aaromalonline/cardiokey/README.md

[↗️ Zeroth presentation](https://www.canva.com/design/DAG_zeX-wzA/ZkK1dH2pC3Fdq6ULEdo5fw/edit)  
[overleaf](https://www.overleaf.com/project/699ae507008f60bd259c76a1)  
[notebooklm](https://notebooklm.google.com/notebook/c7a1f9f1-c57d-4788-8593-7c4eff9a2088)
