aaromalonline/cardiokey/ppt_report/CardioKey(ECGID)-Zerothppt.pdf

### Analog ECG Signal Acquisition & Biometrics

# CardioKey (ECGID)

### Mini-project

# Team Members :

## 1. Aardra S V - 24101868 2.Aaromal A - 24101880 3.Abdulla Hilal V K - 24101000 4.Abhijith R S - 24102771

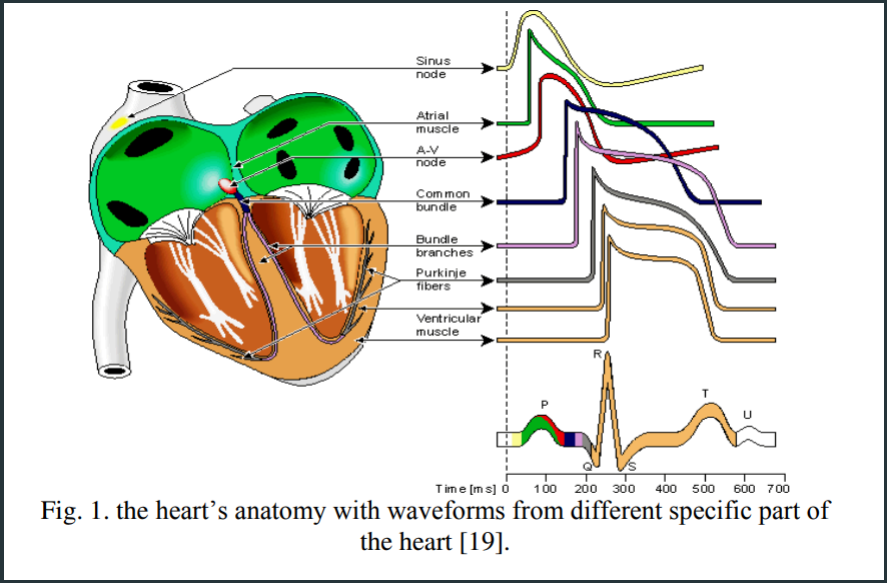
[picture p26: figure]

Traditional biometric methods (fingerprint, face ID) are vulnerable to spoofing and external modification. Passwords and tokens can be stolen or lost.

We propose to build a analog implimentation of Electrocardiogram (ECG) as a biometric identifier. The core of ECGID lies in the unique anatomical and physiological characteristics of an individual's heart, which dictate the specific morphology of the P, QRS, and T waves.

# Abstract

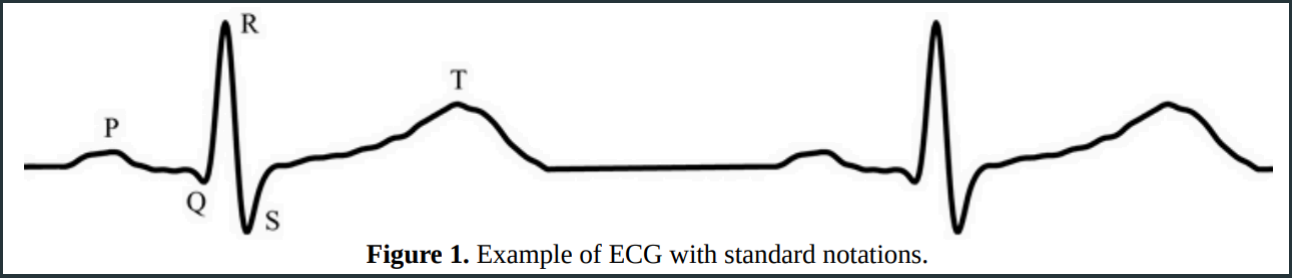
[picture p27: figure]

## P Wave

Represents the first
upward deflection and
atrial depolarization

## QRS Complex

Composed of Q, R, and S
waves; represents
ventricular
depolarization. This is the most distinctive fragment
for identification.

## T Wave

Represents ventricular
repolarization,
concurrent with the end
of ventricular systole.

## U Wave

A series of waves
following the T wave,
discernible in some
tracings.

# 1. ECG & Characteristics

Muscle contraction causes depolarization, which is detected as voltage changes on the skin's surface over time.

two cardiac cycles

1
Universality : Every living human generates ECG signals continuously.

2

4

3

# key points of biometric identification

### Uniqueness: Waveforms are influenced by heart location, size, geometric shape, chest

structure, age, and physiological characteristics.

### Stability: Adult heartbeat structures are basically fixed; waveforms remain stable over

time unless lesions or major pathologies (like myocardial infarction) occur.

### Measurability: Modern equipment is miniaturized and portable, allowing for high-precision acquisition. eg : using 12 lead electrodes for accuracy

ECG variability due Heart rate varibility → shortening of diastole duration (the baseline fragment of the ECG) and the ventricular depolarization period (corresponding to the ST segment in the ECG) and attenuation of the R wave amplitude but QRS complex remains constant

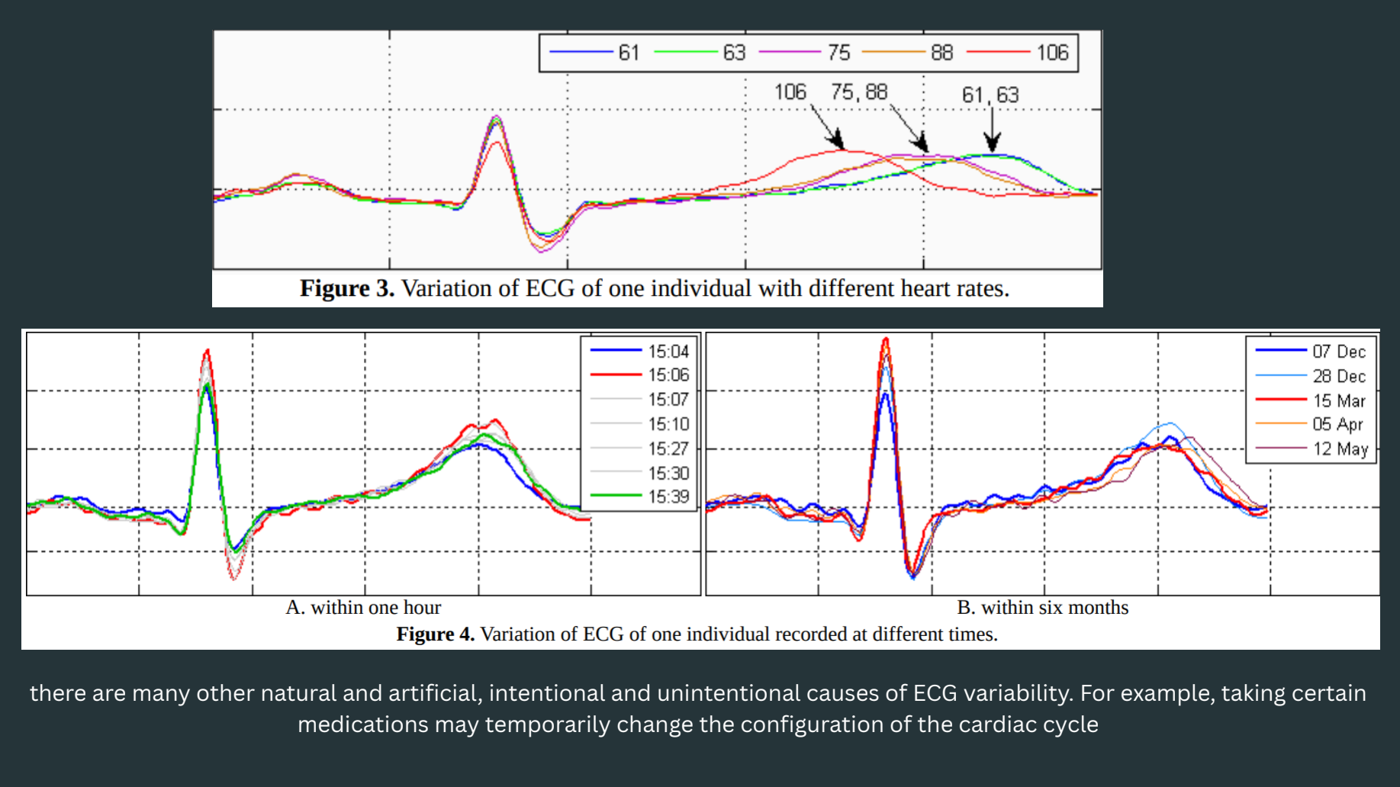
[picture p28: page 6]

there are many other natural and artificial, intentional and unintentional causes of ECG variability. For example, taking certain medications may temporarily change the configuration of the cardiac cycle

The system utilizes a precision analog front-end based on the AD620 instrumentation amplifier to acquire low-amplitude heart signals. This signal is digitized and processed using digital signal processing (DSP) techniques to extract the P-QRS-T complex.

# Methodology

### Hardware components : ECG Analog Signal Acquisition

3 electrodes (1Lead LA-RA, feedback), AD620 instrumentation amp, AD705J, IC741 opamps for filters and

### amplifiers, and resistors & capacitors → AD8232 ECG sensor Diodes for DC offset circuit, AD115 16bit ADC, a MCU (ESP32)

### Software components : ECG Digital Signal Analysis & Biometrics

### MATLAB or Python, TinyML and algorithms for signal analysis

# 2. Analog ECG Signal Acquisition - Hardware

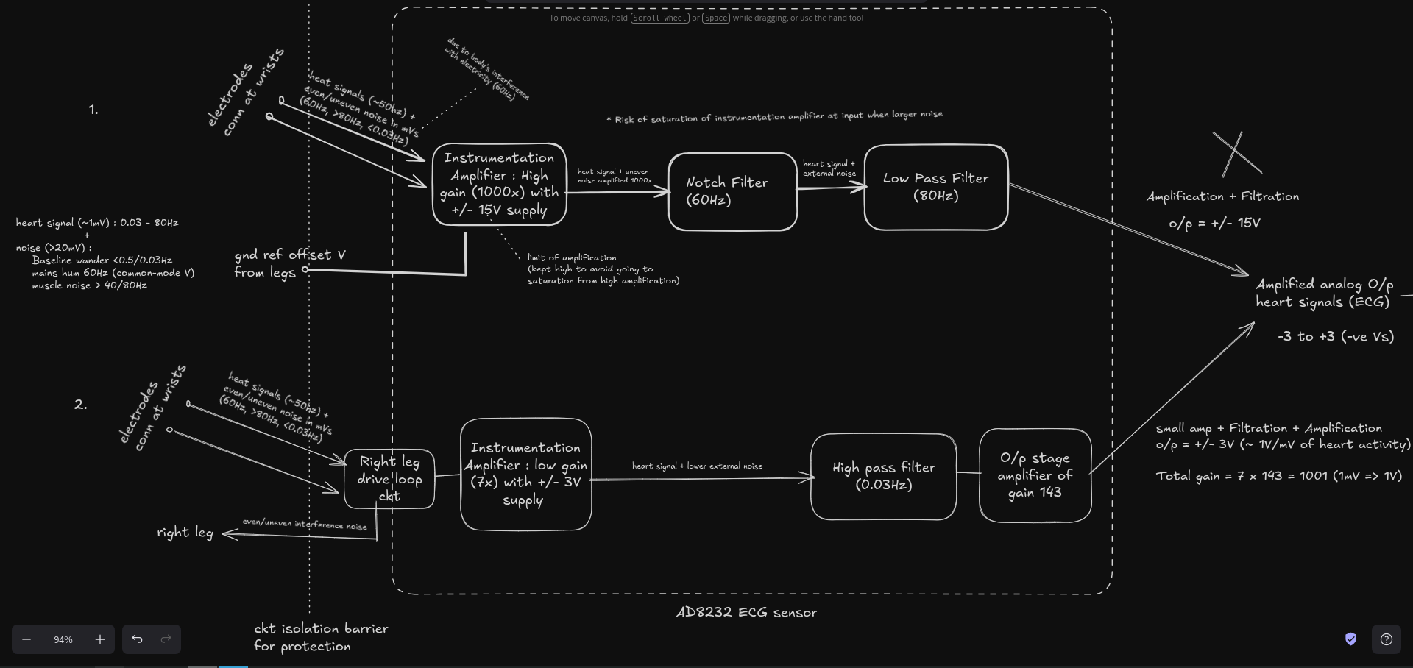
[picture p29: page 8]

two approaches

## Right leg drive circuit

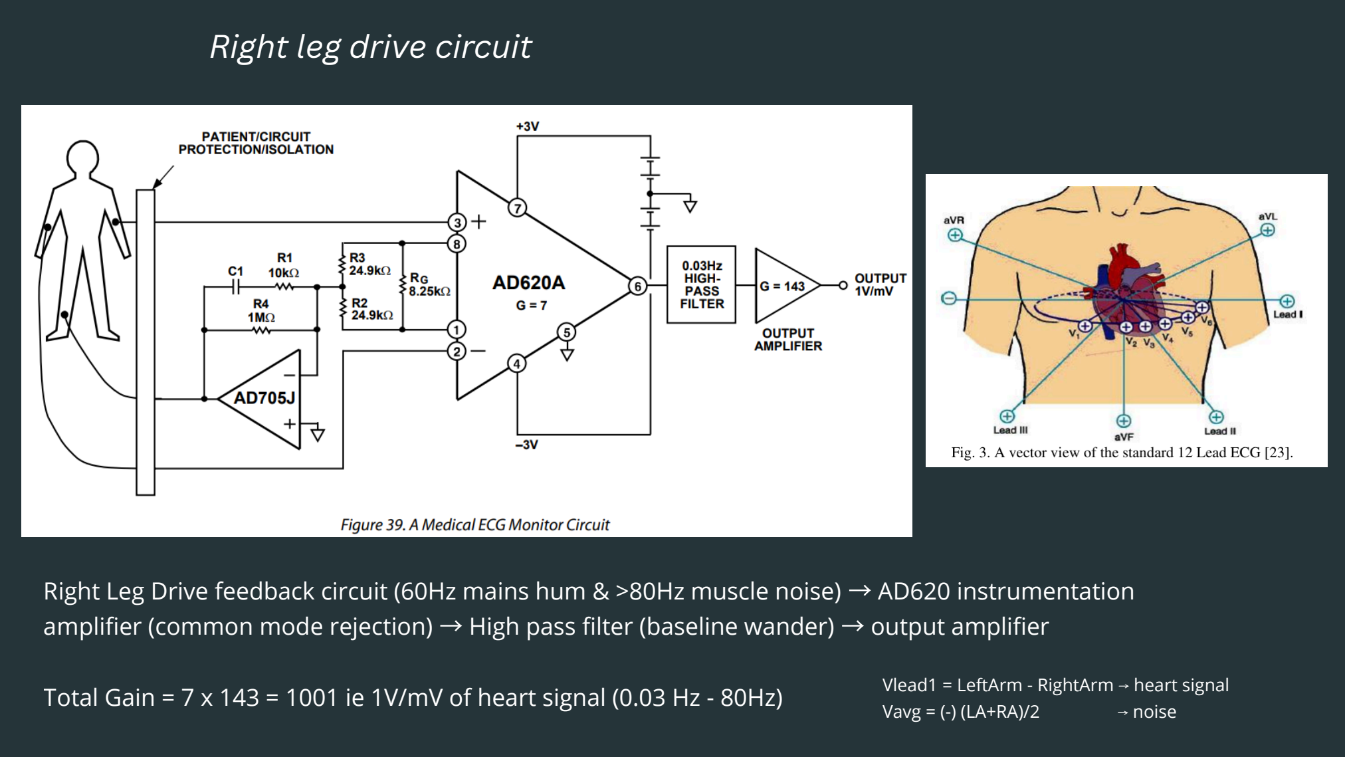
[picture p30: page 9]

Right Leg Drive feedback circuit (60Hz mains hum & >80Hz muscle noise) → AD620 instrumentation amplifier (common mode rejection) → High pass filter (baseline wander) → output amplifier

Total Gain = 7 x 143 = 1001 ie 1V/mV of heart signal (0.03 Hz - 80Hz)

Vlead1 = LeftArm - RightArm ⟶ heart signal
Vavg = (-) (LA+RA)/2 | ⟶ noise

## Simulation & Tests :

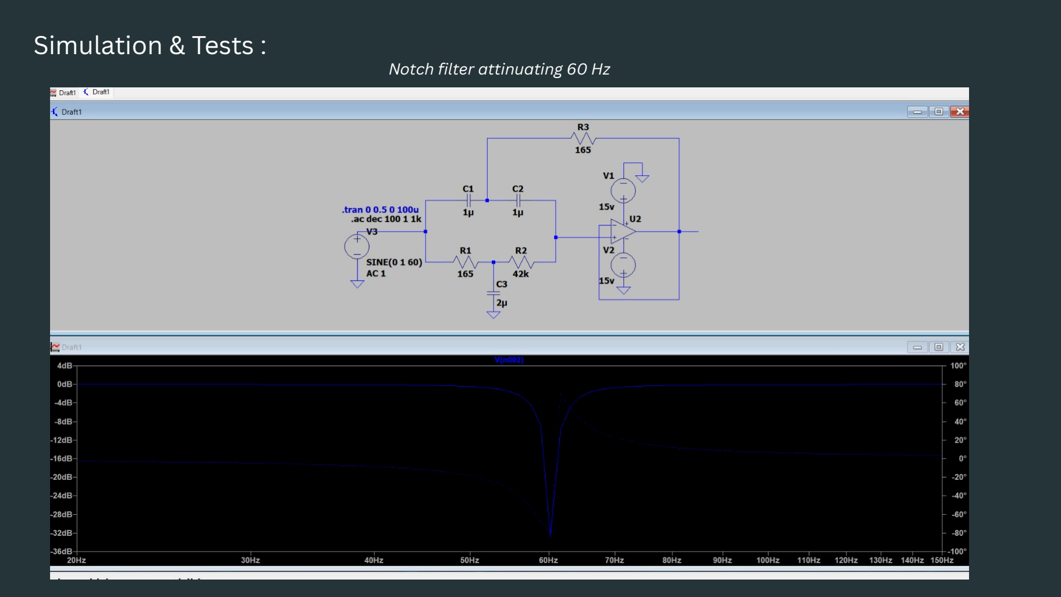
[picture p31: page 10]

Notch filter attinuating 60 Hz

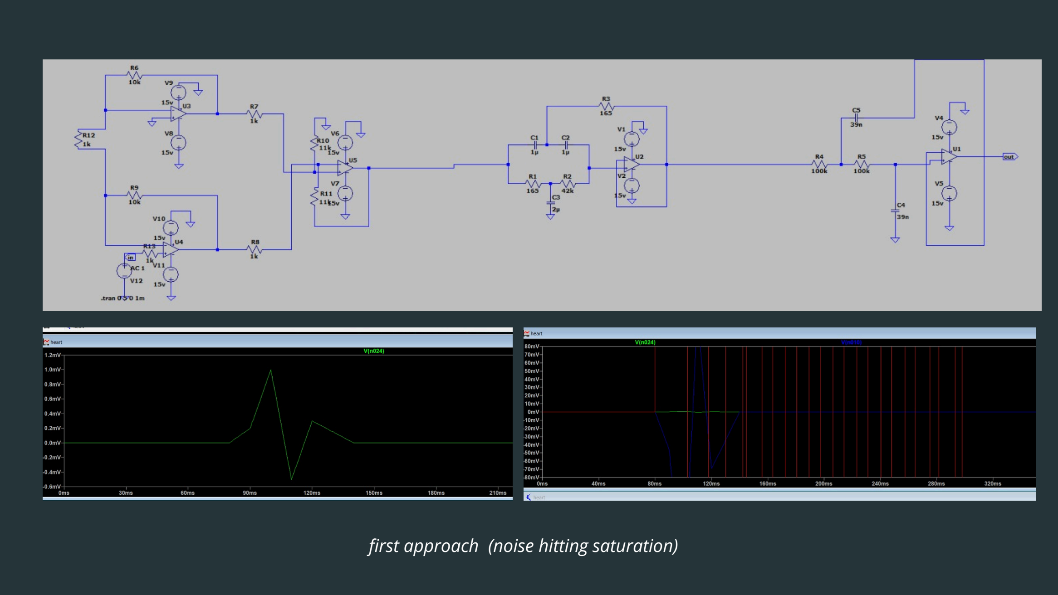
[picture p32: page 11]

first approach (noise hitting saturation)

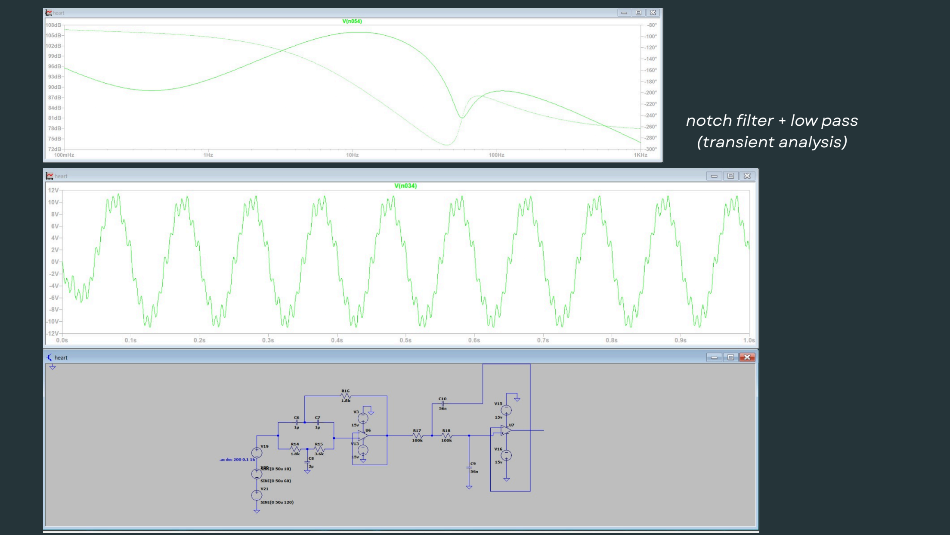
[picture p33: page 12]

notch filter + low pass
(transient analysis)

# 3. ECG Digital Signal Analysis - Software

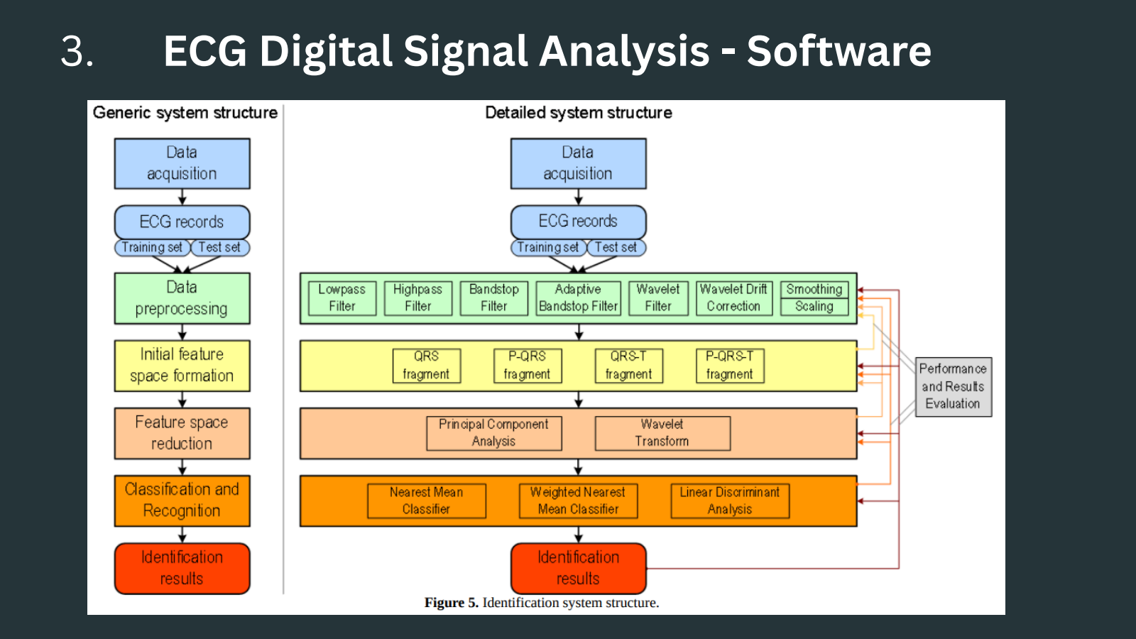
[picture p34: page 13]

1 Data Acquisition : Single-lead ECG (Lead I: Left Arm – Right Arm), sample 500Hz, 16bit signal

2

4

3

Data Preprocessing (Cleaning) : Drift Correction for baseline wander (wavelet decomposition or high pass), Mains hum removal (Adaptive Bandstop/notch filter), HIgh frequency cleanup (low pass butterworth 50-80Hz)

Initial Feature Space Formation : "Segmentation" phase where the continuous signal is chopped into individual heartbeats (cardiac cycle), Fragment Selection (P-QRS-T fragment out of QRS, P-QRS, QRS-T, and P-QRS-T windows provided the highest accuracy because the P-wave contains significant individual data), Window Size (window length of 0.5 seconds (250 samples) for every beat) aligned with R peak reference (80 samples before the peak and 170 samples after it), extracted 10 beats per record to choose a mean beat.

Feature Space Reduction (PCA) : Raw P-QRS-T window of 250 data points compressed into 30 pricipal components (vectors) using normalisation and dimensionality reduction for nullifying heart rate variations.
5

Classification & Identification : This final stage compares the user's 30-point "signature" against the database using Nearest Mean, Weighted Nearest Mean, or Linear Discriminant Analysis (LDA) algorithms with majority matches for multiple beats (cardiac cycle).

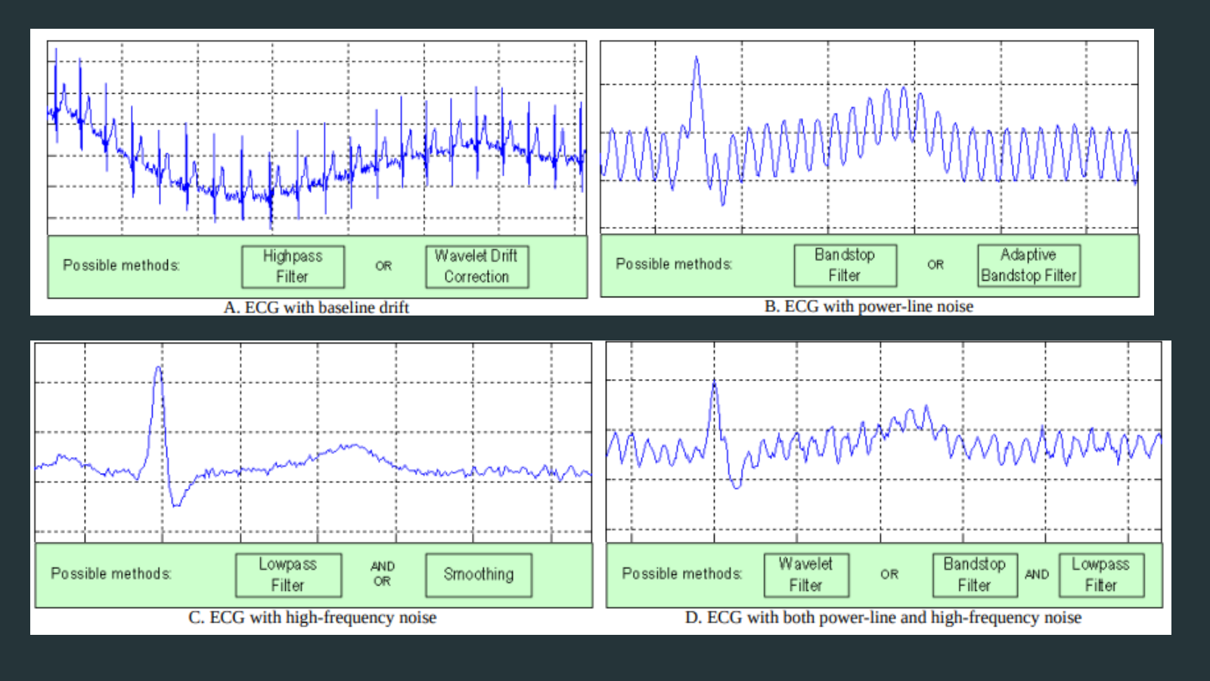
[picture p35: page 15]
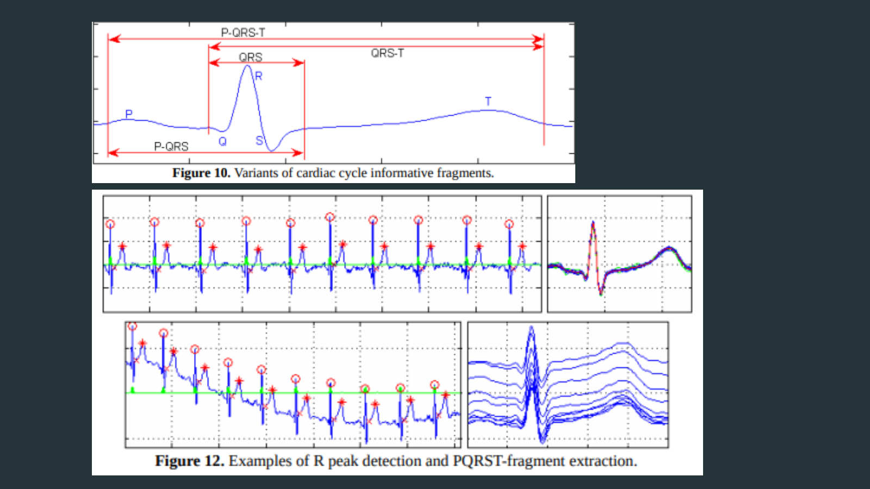
[picture p36: page 16]

## Observations :

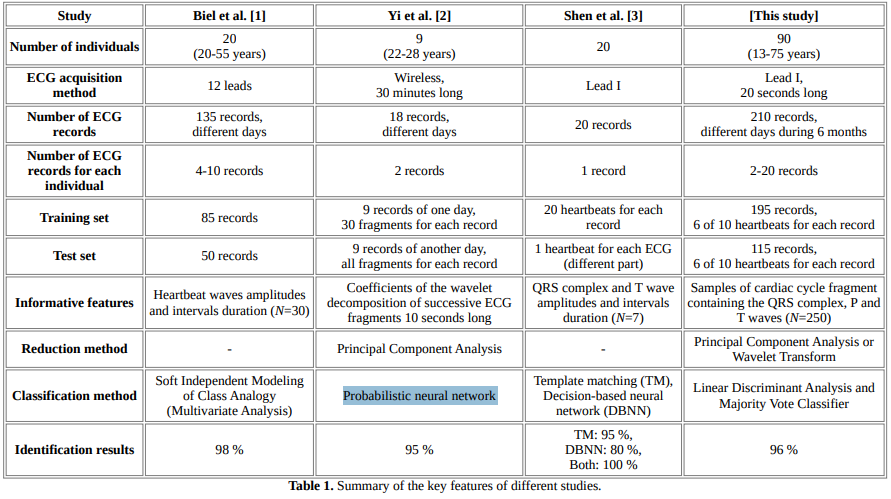
[picture p37: page 17]

# Conclusion

Project Viability
The "CardioKey" system demonstrates that the Electrocardiogram (ECG) is a viable, universal, and unique biometric trait for human identification.
Research confirms that using a Single-Lead (Lead I) configuration can achieve identification accuracy rates as high as 96% under controlled conditions.

Advantages Over Traditional Biometrics
ECG biometrics provides inherent "Liveness Detection,

" making it superior to fingerprint or face ID, which can be spoofed by static images or models.
It offers a continuous method of authentication that is difficult to forge or steal.

Future Scope & Challenges
The primary challenge remains Heart Rate Variability (HRV). As identified in recent studies, identification accuracy drops significantly (the "Rest-Ex" problem) if the user has just exercised.
Future improvements will focus on advanced Normalization Algorithms (scaling the QT interval) to ensure the system remains robust even when the user's heart rate is elevated, also introducing more leads for accuracy.

# References

https://scispace.com/pdf/heart-rate-monitoring-and-pqrst-detection-based-on-graphical-2s4gcfab00.pdf

https://www.physionet.org/physiobank/database/ecgiddb/biometric.shtml

https://www.sciencedirect.com/science/article/pii/S2667099221000086

https://repository.lib.pcr.ac.id/id/eprint/1602/1/Paper%20PQRST%20wave%20detection%20on%20ECG%20signals%20(1).pdf

https://repository.lib.pcr.ac.id/id/eprint/1602/1/Paper%20PQRST%20wave%20detection%20on%20ECG%20signals%20(1).pdf (https://www.instructables.com/Make-Your-Own-Electrocardiogram-ECG/)

https://www.analog.com/media/en/technical-documentation/data-sheets/AD620.pdf
