aaromalonline/cardiokey/ck-client_app/outs/pred/subj1-pred.jpeg

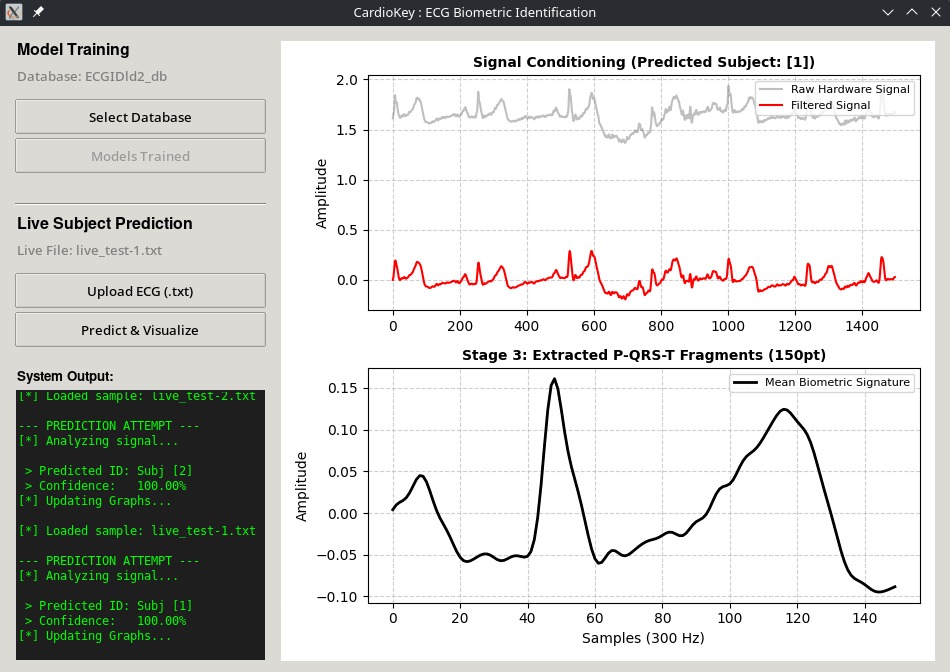
ck-client_app/outs/pred/subj1-pred.jpeg
