aaromalonline/cardiokey/ck-client_app/outs/pred/subj1-prednew.jpeg

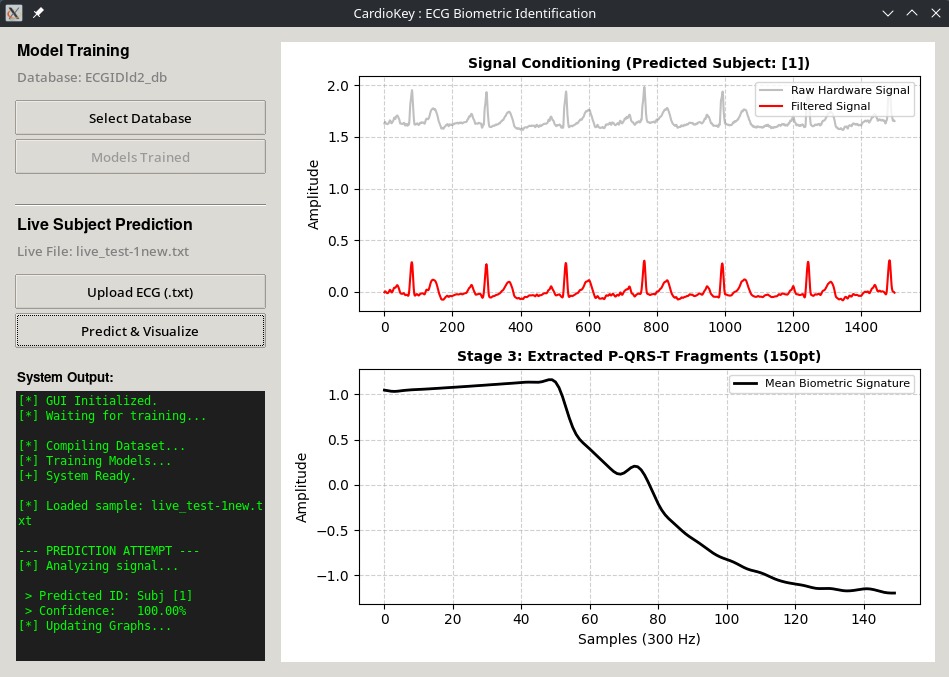
ck-client_app/outs/pred/subj1-prednew.jpeg
