aaromalonline/cardiokey/ck-client_app/outs/pred/subj2-pred.jpeg

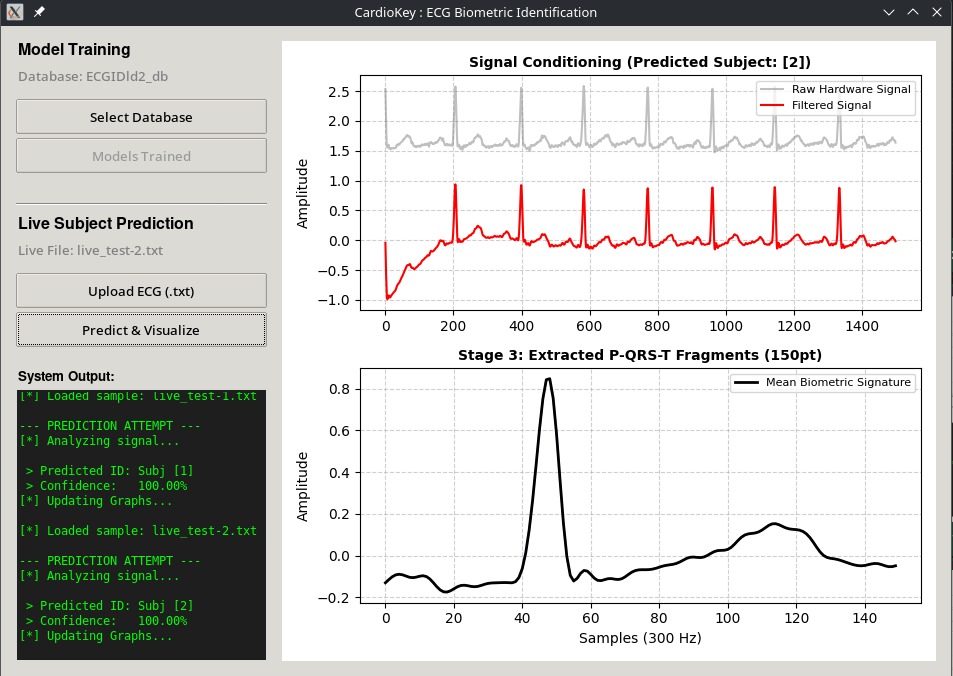
ck-client_app/outs/pred/subj2-pred.jpeg
