aaromalonline/cardiokey/ck-client_app/outs/rec/subj1-dbrec.jpeg

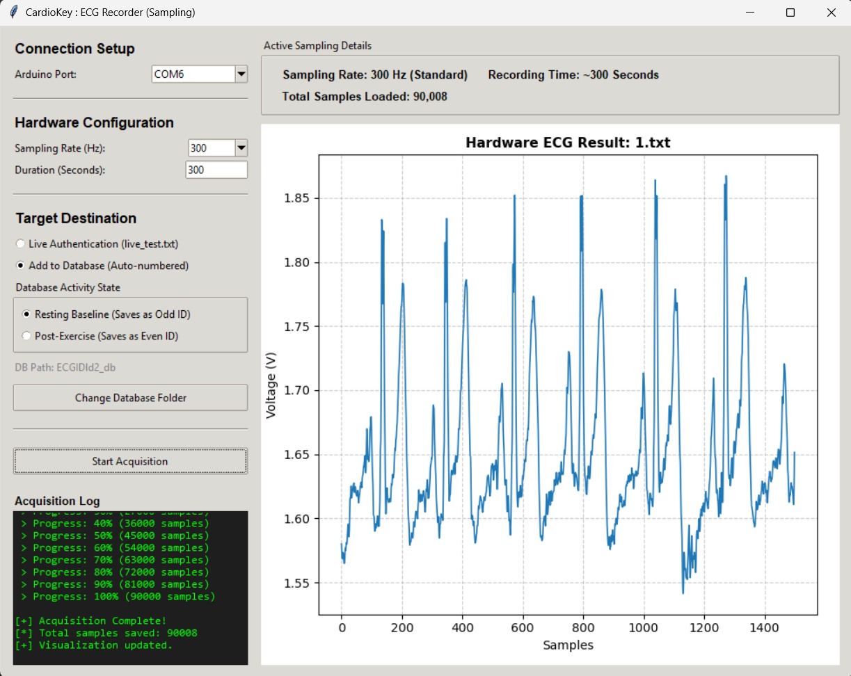
ck-client_app/outs/rec/subj1-dbrec.jpeg
