aaromalonline/cardiokey/ck-client_app/outs/rec/subj2-dbrec.jpeg

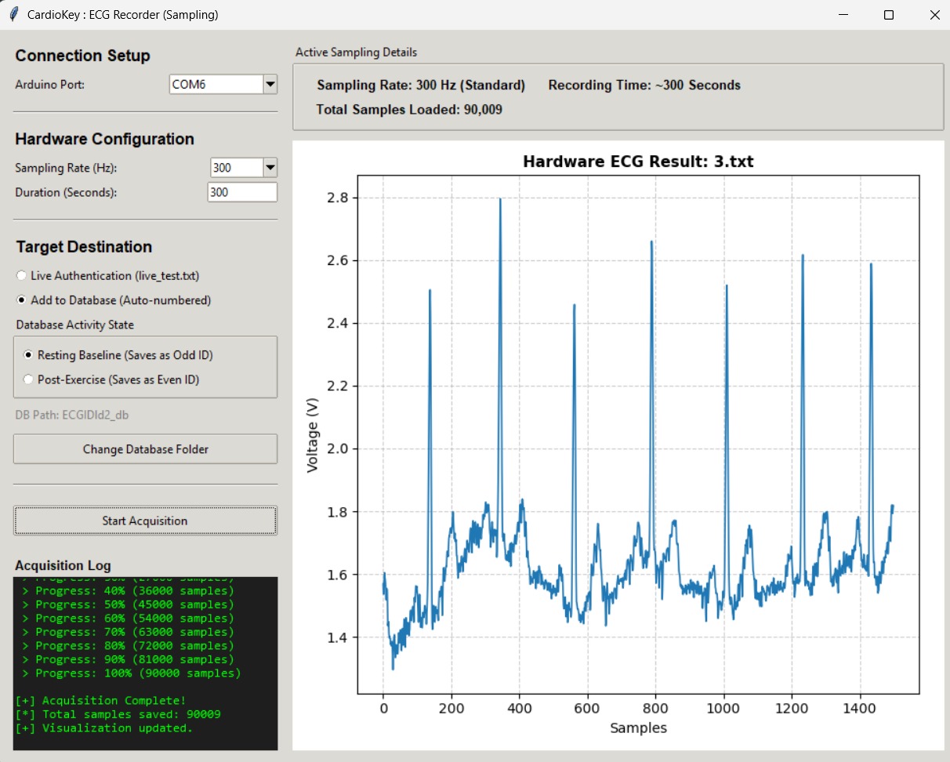
ck-client_app/outs/rec/subj2-dbrec.jpeg
