aaromalonline/cardiokey/ecgacq_plot/outputs/Figure_1.png

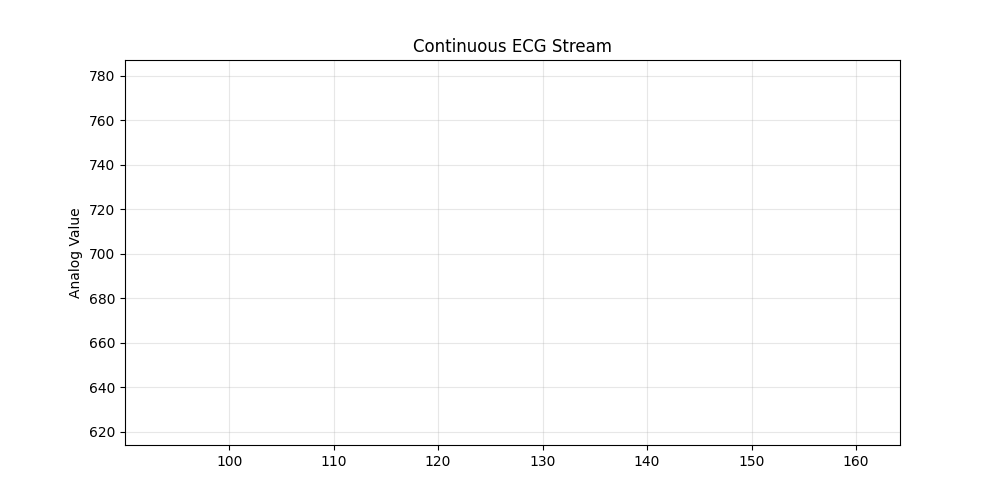
ecgacq_plot/outputs/Figure_1.png
