aaromalonline/cardiokey/ecgacq_plot/outputs/jupyter_out1.png

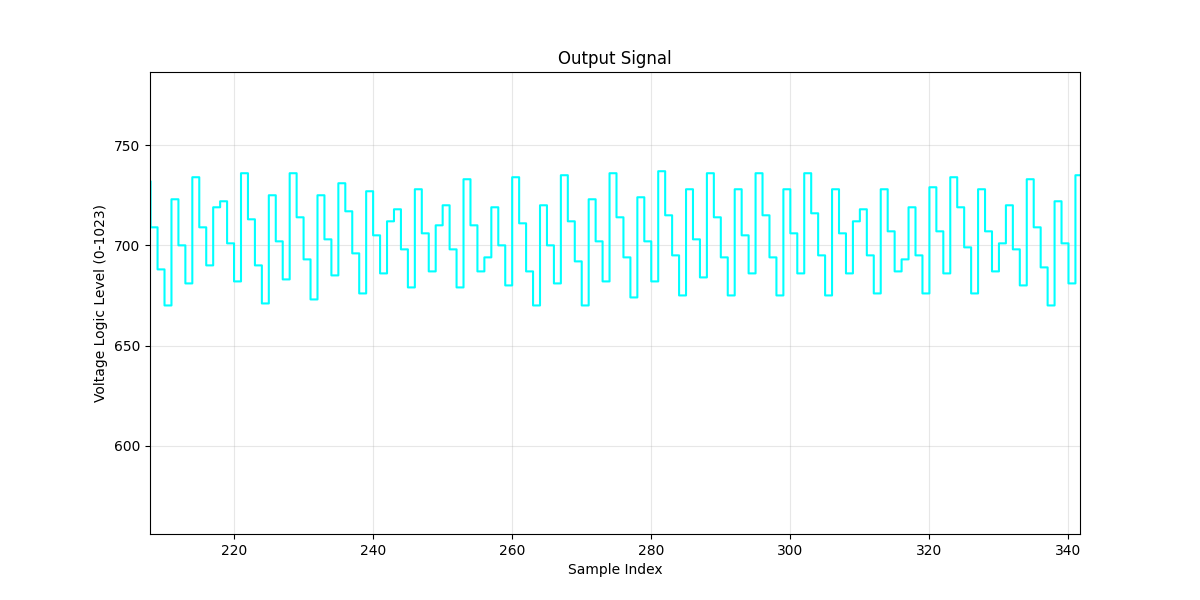
ecgacq_plot/outputs/jupyter_out1.png
