aaromalonline/cardiokey/ecgacq_plot/outputs/serialplot_2.png

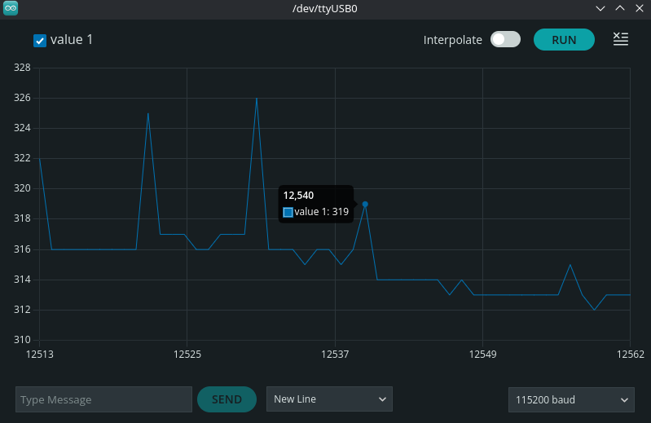
ecgacq_plot/outputs/serialplot_2.png
