aaromalonline/cardiokey/ecgacq_plot/outputs/serialplot_out1.png

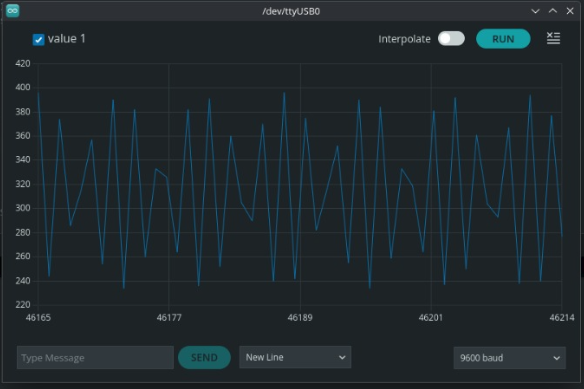
ecgacq_plot/outputs/serialplot_out1.png
