aaromalonline/cardiokey/ecgdata_classification/client_interface-sample/ecg_predict.png

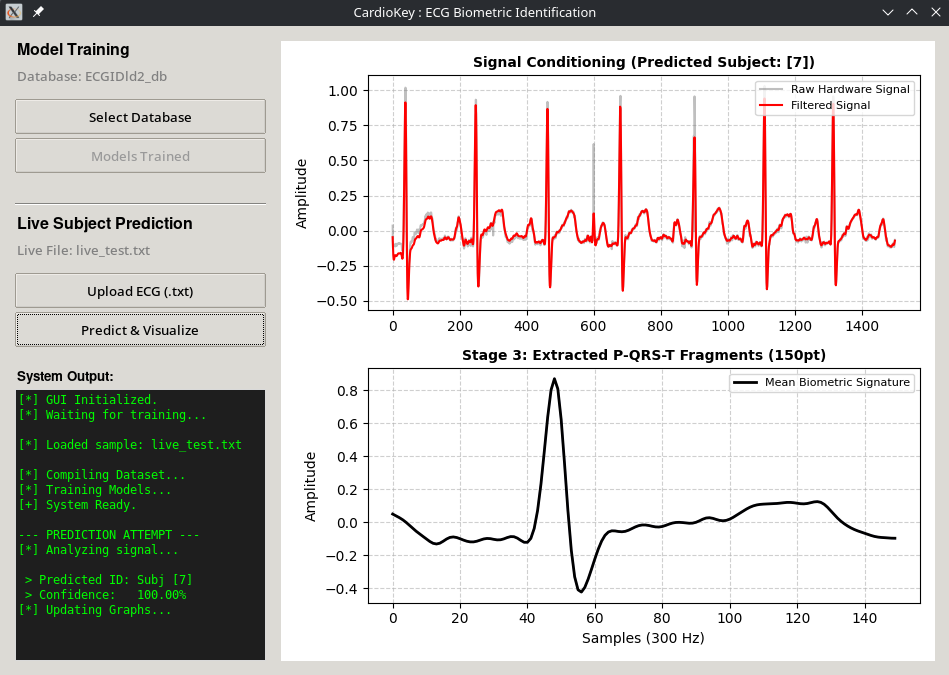
ecgdata_classification/client_interface-sample/ecg_predict.png
