aaromalonline/cardiokey/ecgdata_classification/client_interface-sample/ecg_record.png

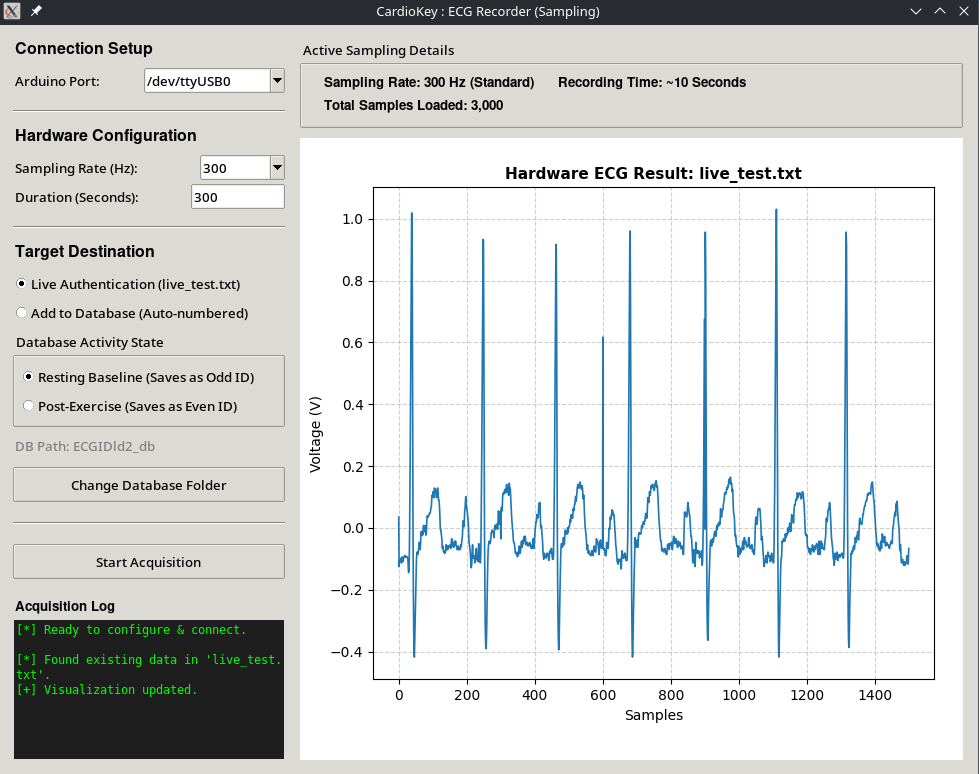
ecgdata_classification/client_interface-sample/ecg_record.png
