aaromalonline/cardiokey/ecgdata_classification/clplot/subj1/150pt_cardiaccycl-frag.png

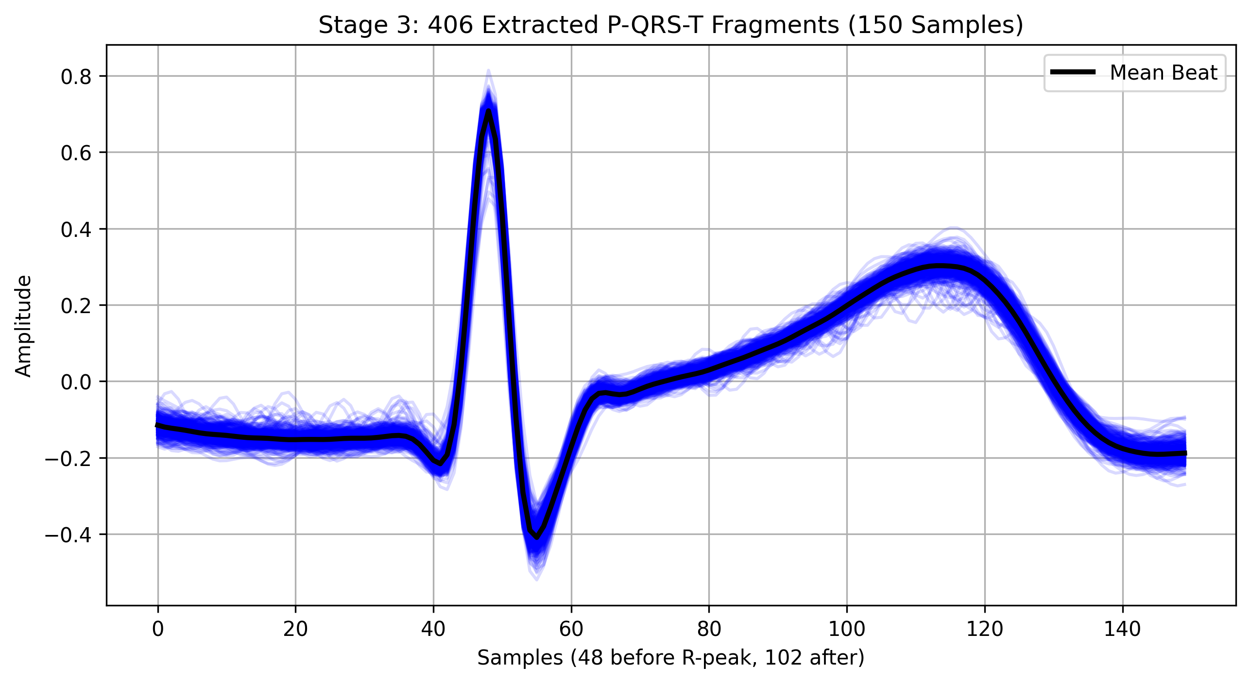
ecgdata_classification/clplot/subj1/150pt_cardiaccycl-frag.png
