aaromalonline/cardiokey/ecgdata_classification/clplot/subj1/150ptfrag_cycl-hratevar.png

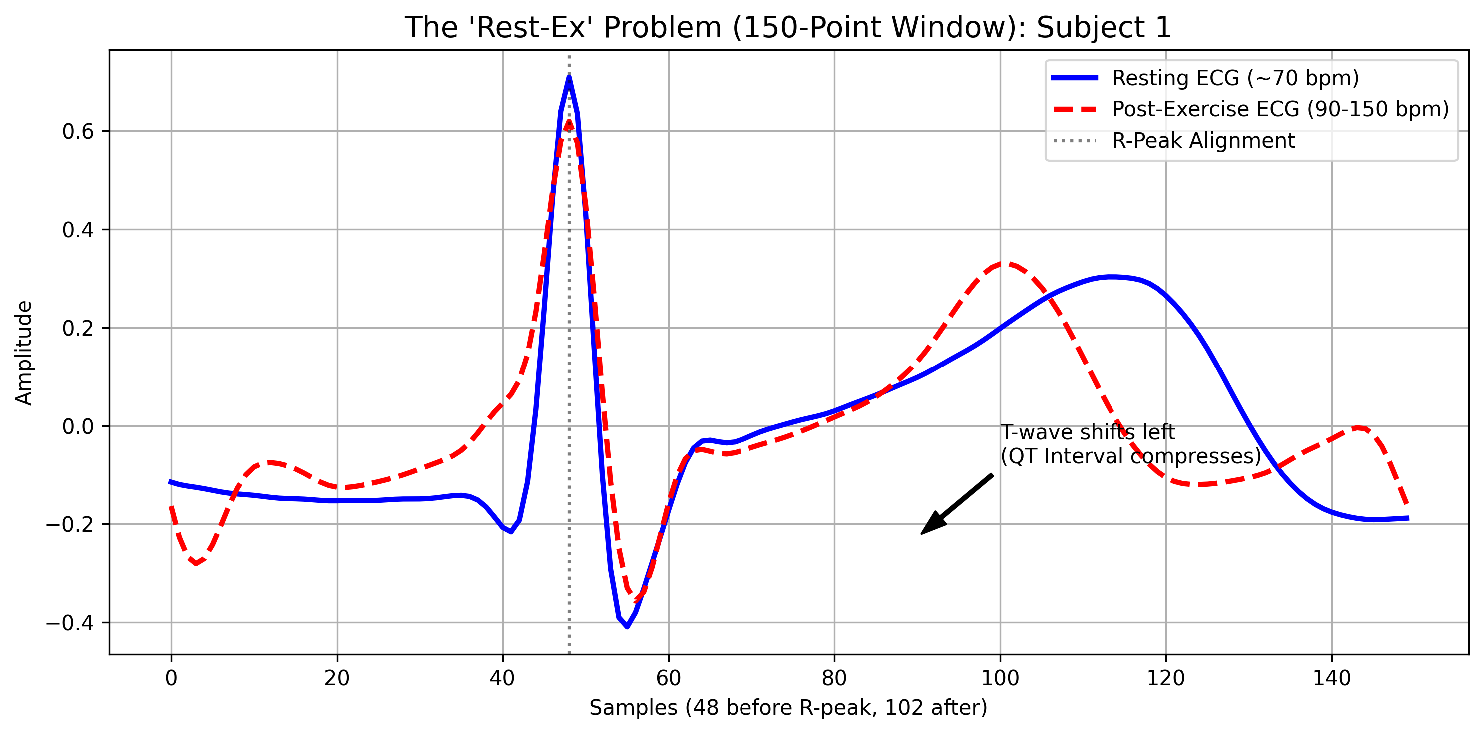
ecgdata_classification/clplot/subj1/150ptfrag_cycl-hratevar.png
