aaromalonline/cardiokey/nnarch/arch-h.png

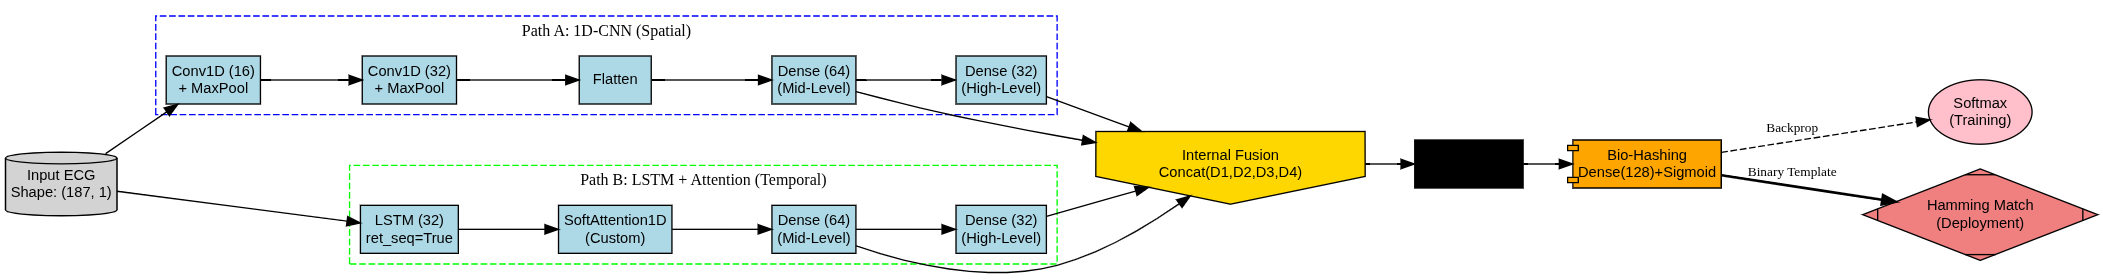
nnarch/arch-h.png
