aaromalonline/cardiokey/nnarch/arch.png

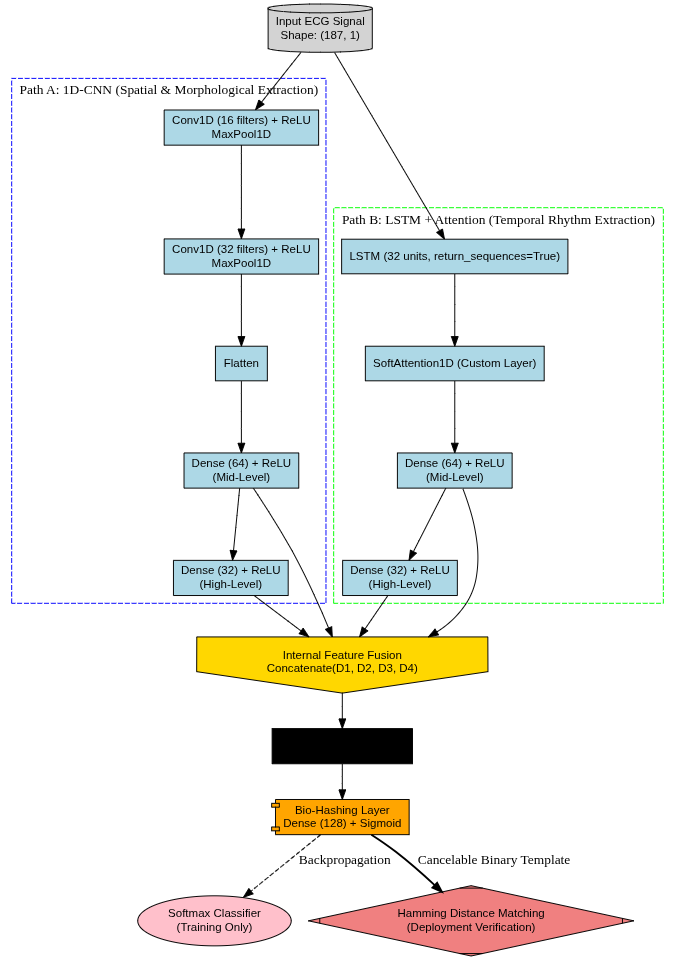
nnarch/arch.png
