aaromalonline/cardiokey/nnarch/lifecycle-h.png

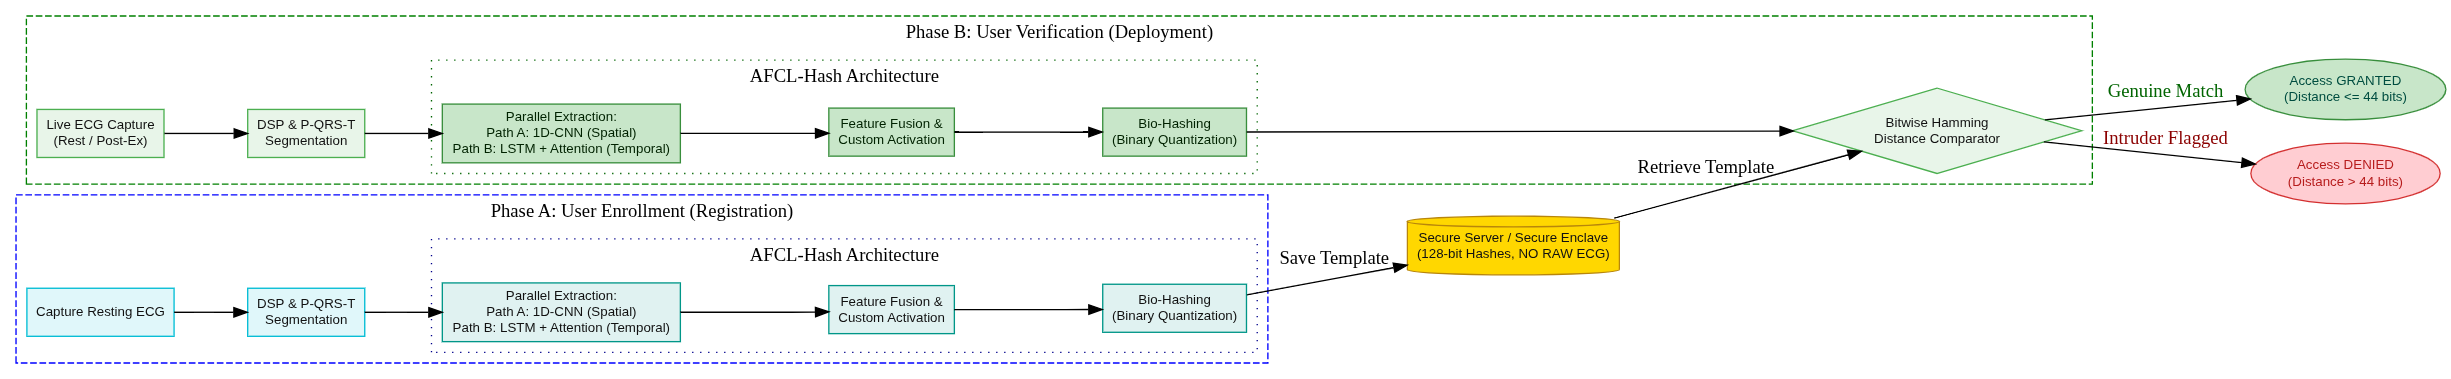
nnarch/lifecycle-h.png
