aaromalonline/cardiokey/nnarch/lifecycle.png

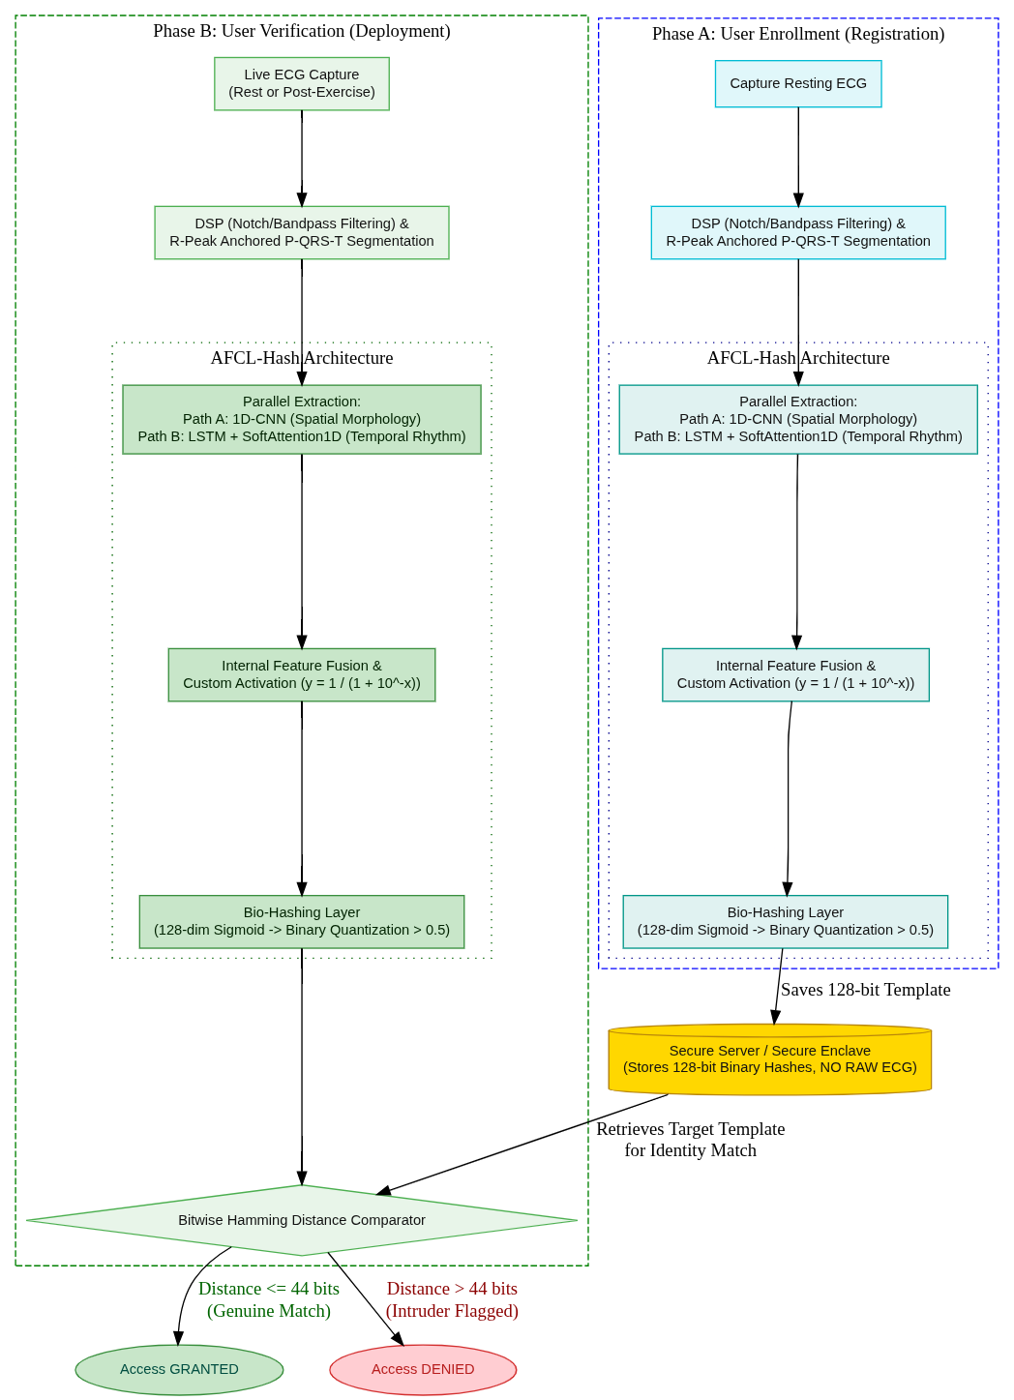
nnarch/lifecycle.png
