aaromalonline/cardiokey/exp_setup/filtnoout_wrist/1.jpeg

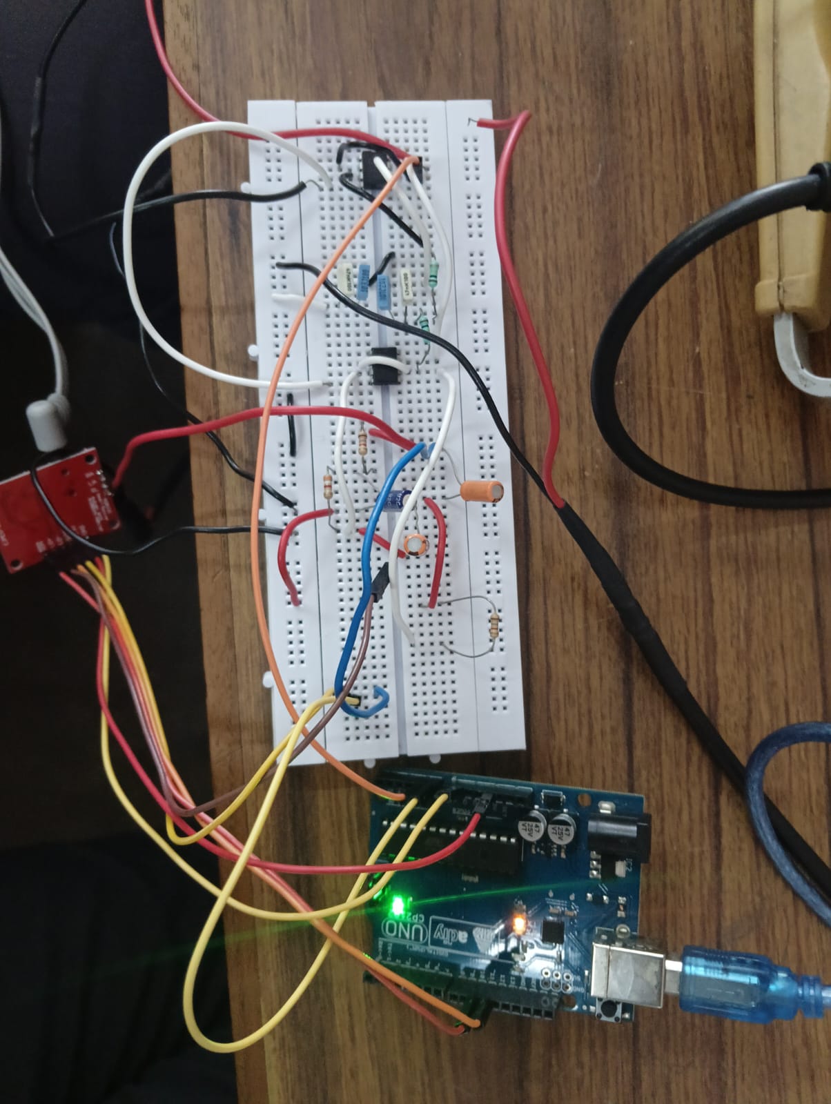
exp_setup/filtnoout_wrist/1.jpeg
