aaromalonline/cardiokey/exp_setup/filtnoout_wrist/2.jpeg

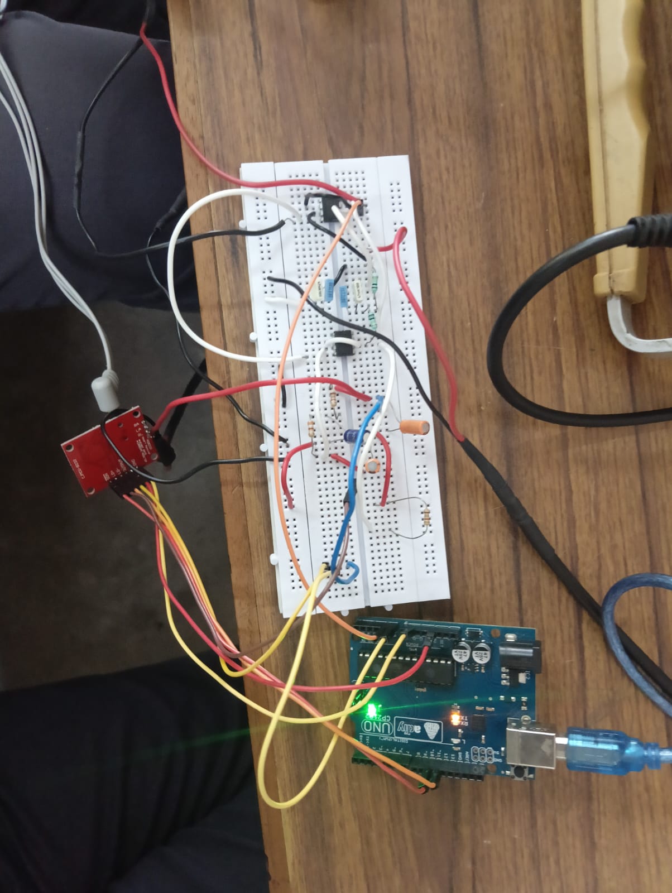
exp_setup/filtnoout_wrist/2.jpeg
