aaromalonline/cardiokey/exp_setup/filtnoout_wrist/3.jpeg

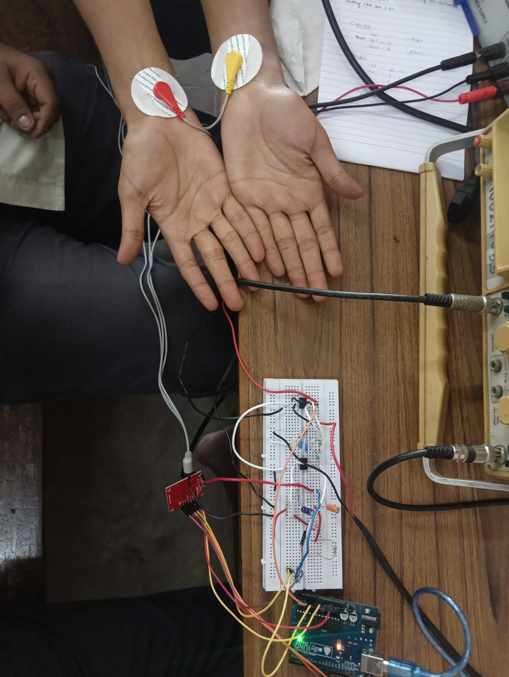
exp_setup/filtnoout_wrist/3.jpeg
