aaromalonline/cardiokey/exp_setup/filtnoout_wrist/4.jpeg

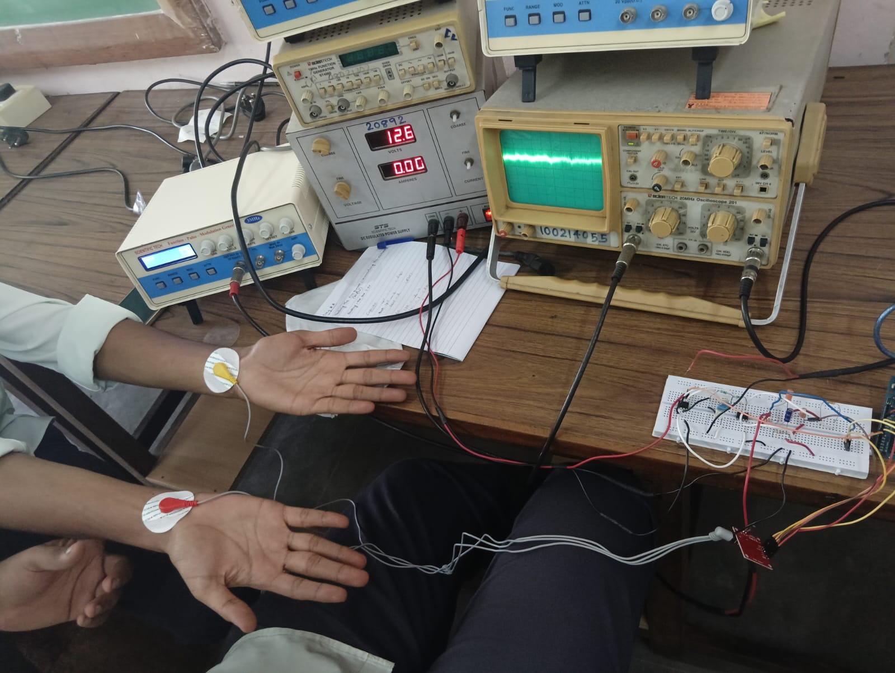
exp_setup/filtnoout_wrist/4.jpeg
