aaromalonline/cardiokey/exp_setup/filtnoout_wrist/5.jpeg

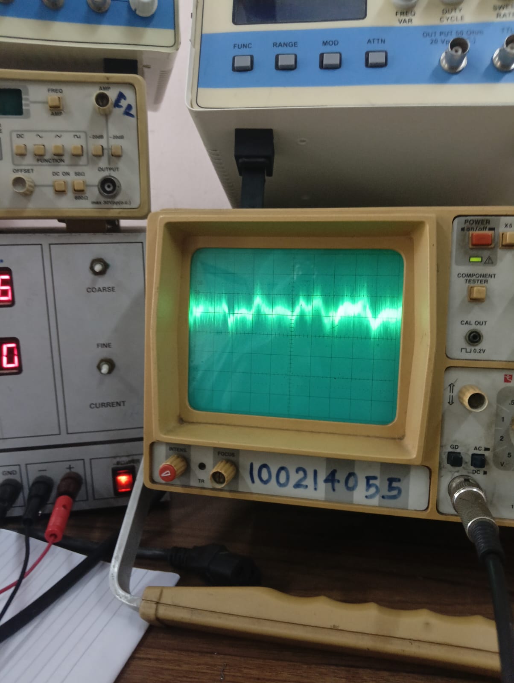
exp_setup/filtnoout_wrist/5.jpeg
