aaromalonline/cardiokey/exp_setup/filtnoout_wrist/6.jpeg

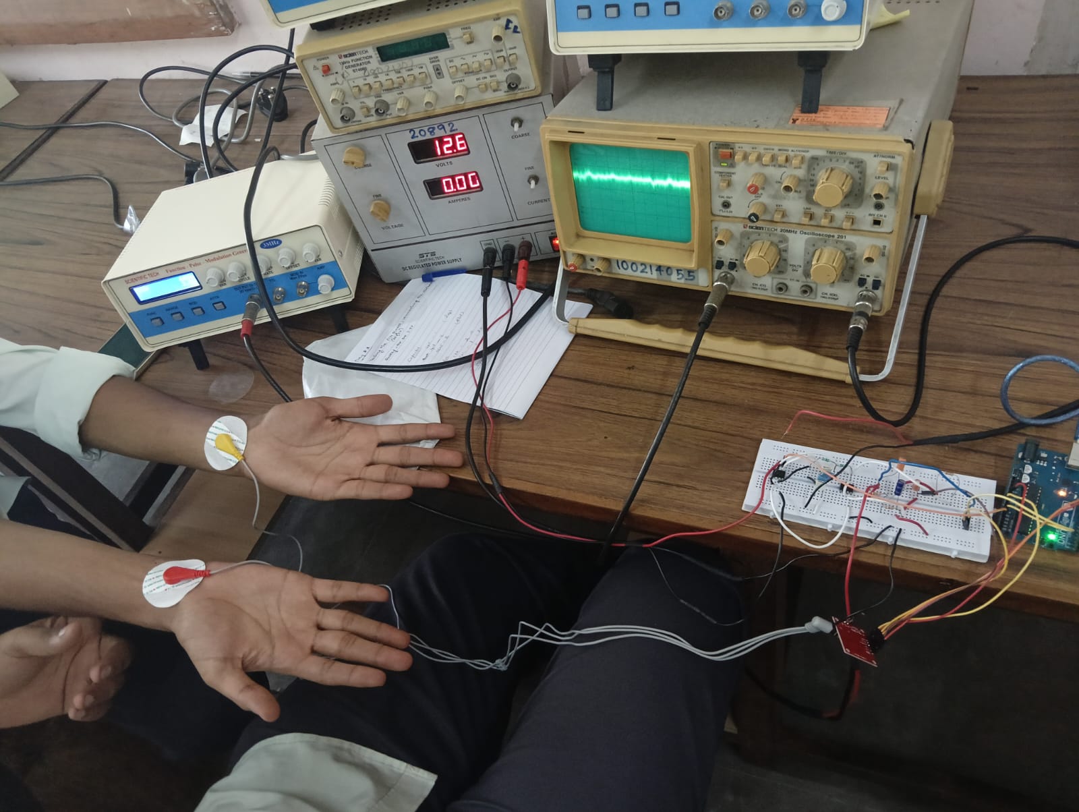
exp_setup/filtnoout_wrist/6.jpeg
