aaromalonline/cardiokey/exp_setup/filtout_chest/1.jpeg

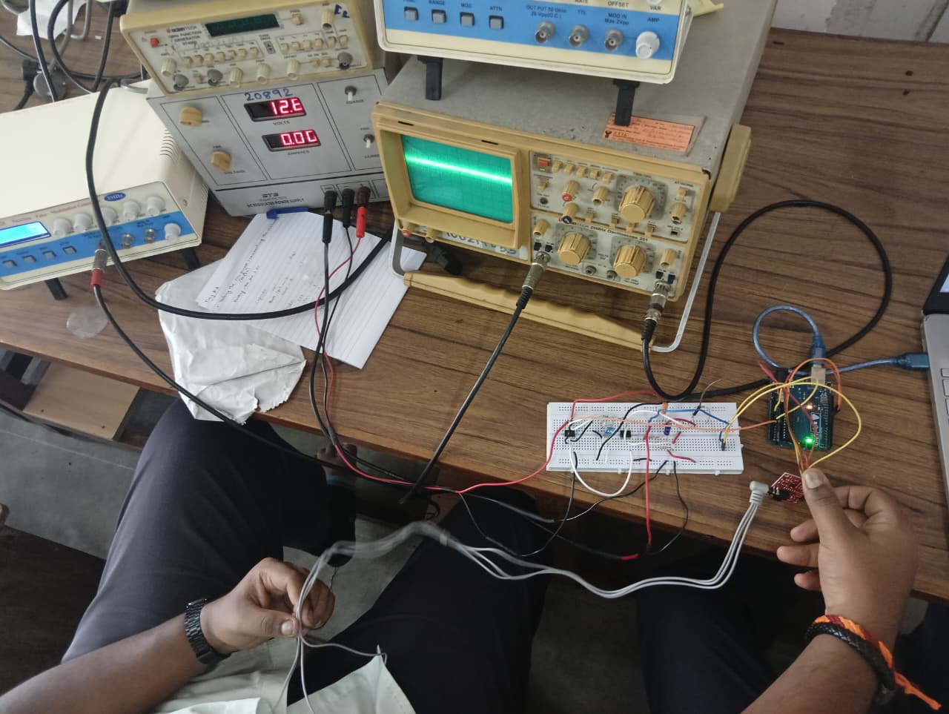
exp_setup/filtout_chest/1.jpeg
