aaromalonline/cardiokey/exp_setup/filtout_chest/2.jpeg

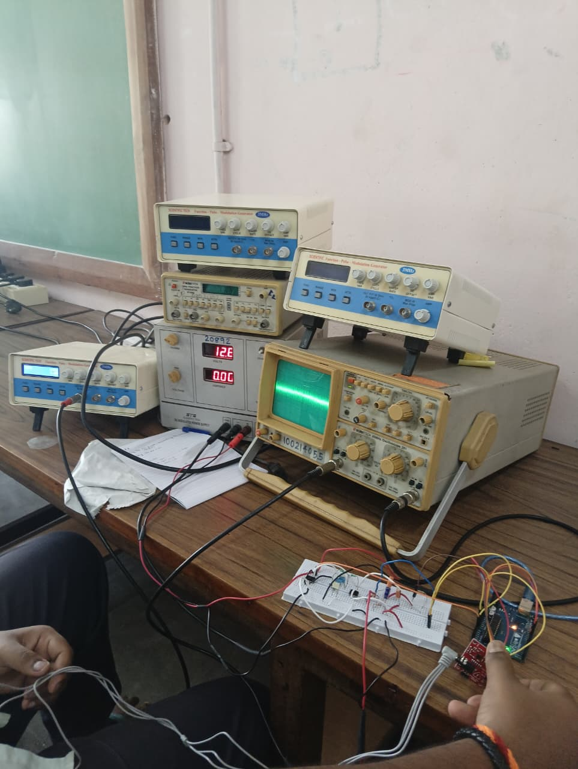
exp_setup/filtout_chest/2.jpeg
