aaromalonline/cardiokey/exp_setup/filtout_chest/3.jpeg

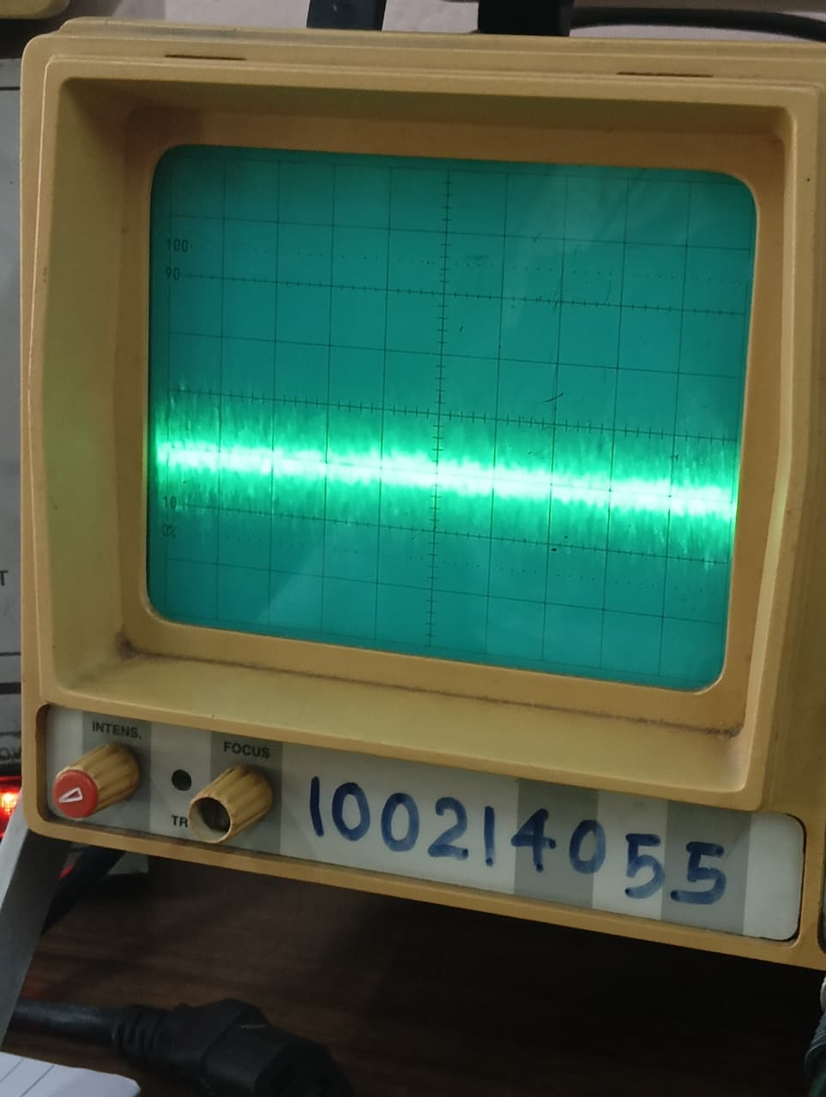
exp_setup/filtout_chest/3.jpeg
