aaromalonline/cardiokey/exp_setup/filtout_chest/4.jpeg

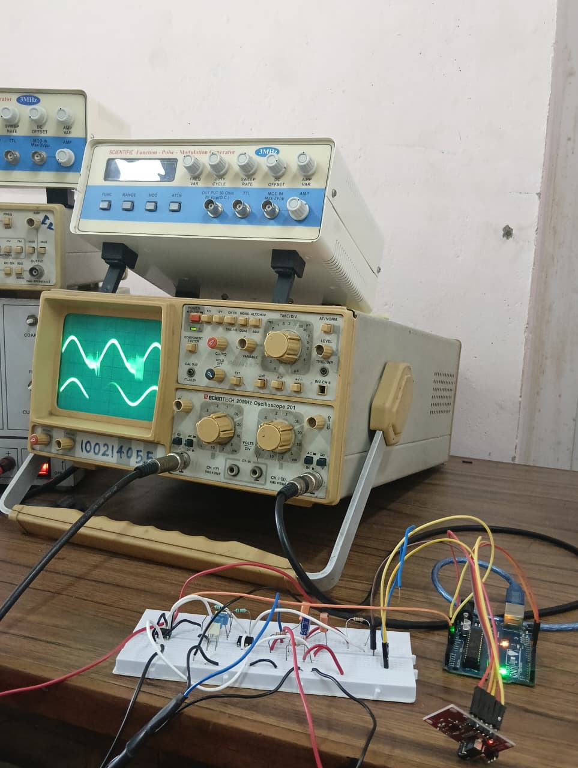
exp_setup/filtout_chest/4.jpeg
