aaromalonline/cardiokey/ck-client_app/outs/rec/subj1-testrec.jpeg

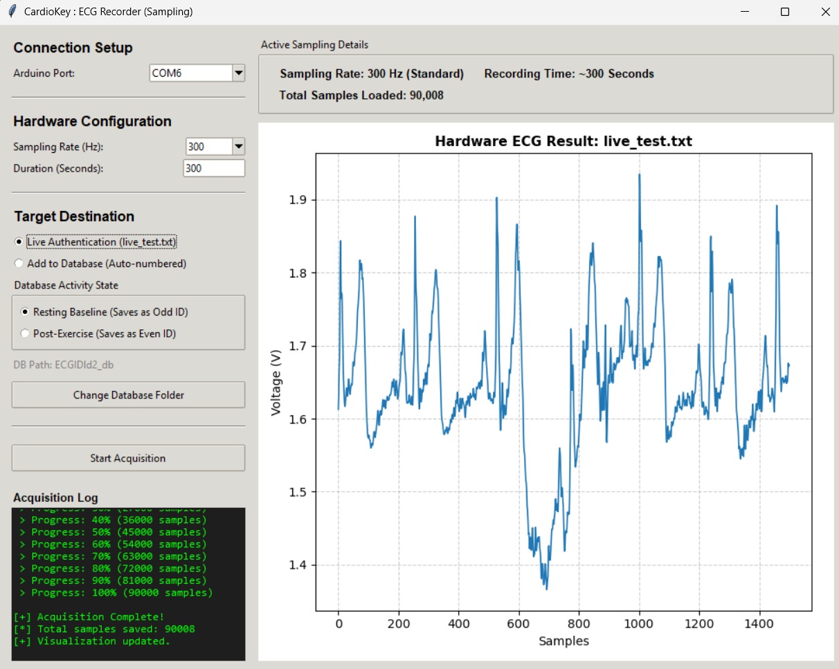
ck-client_app/outs/rec/subj1-testrec.jpeg
