aaromalonline/cardiokey/ck-client_app/outs/rec/subj1-testrecnew.jpeg

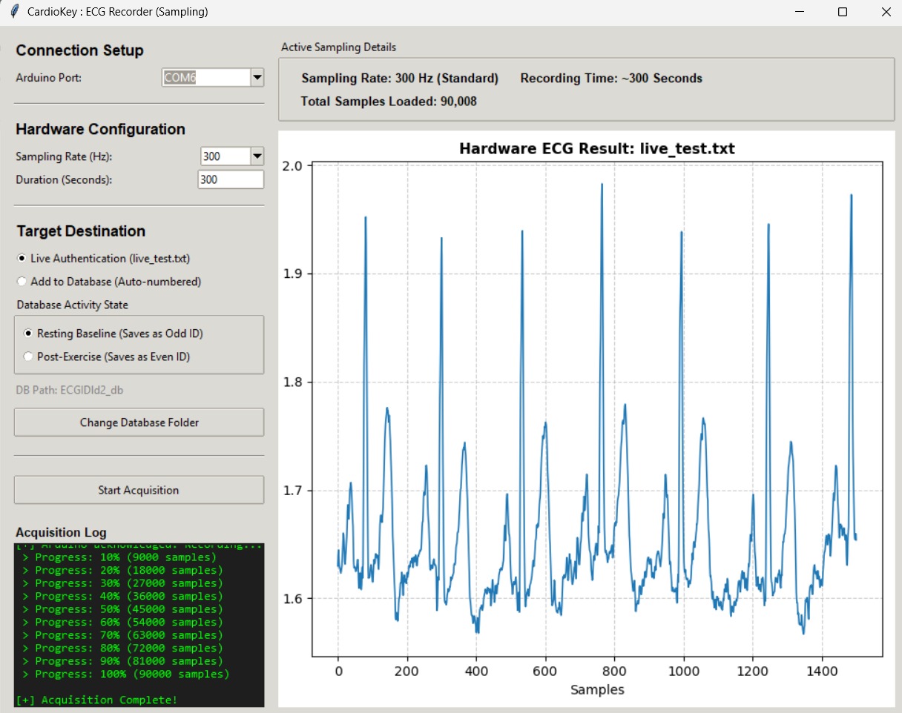
ck-client_app/outs/rec/subj1-testrecnew.jpeg
