aaromalonline/cardiokey/ck-client_app/outs/rec/subj2-testrec.jpeg

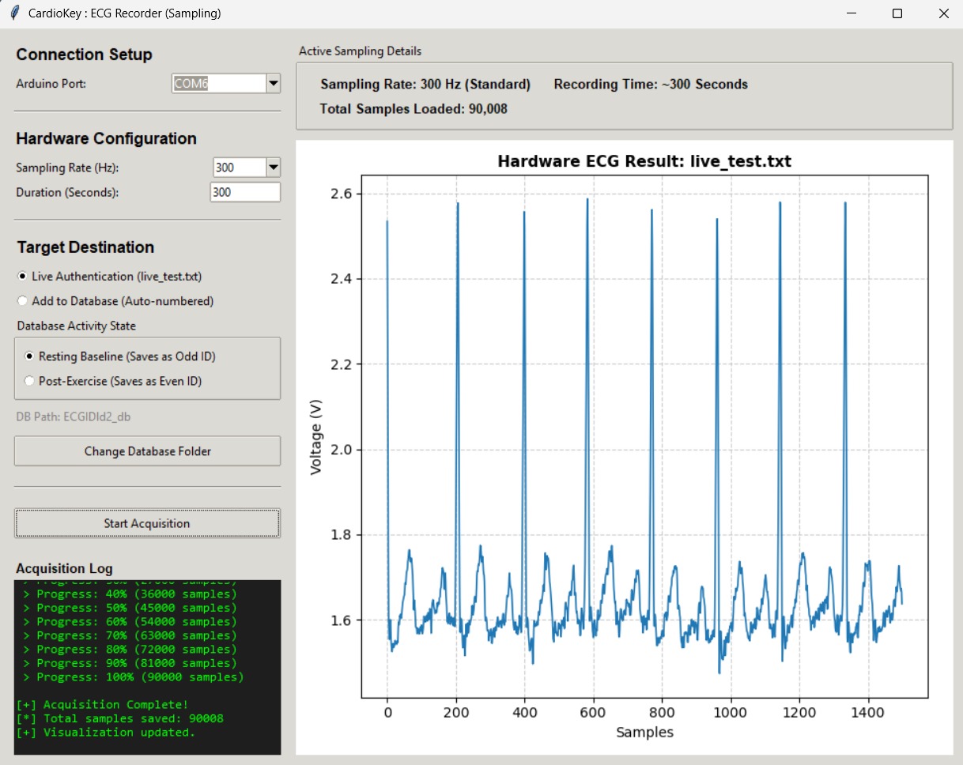
ck-client_app/outs/rec/subj2-testrec.jpeg
