aaromalonline/cardiokey/hdw_des/heart.asc

C1: cap; 1µ
C2: cap; 1µ
C3: cap; 2µ
C4: cap; 39n
C5: cap; 39n
C6: cap; 1µ
C7: cap; 1µ
C8: cap; 2µ
C9: cap; 56n
C10: cap; 56n
C11: cap; 1µ
C12: cap; 1µ
C13: cap; 2µ
C14: cap; 56n
C15: cap; 56n
C16: cap; 5.3µ
R1: res; 165
R2: res; 42k
R3: res; 165
R4: res; 100k
R5: res; 100k
R6: res; 10k
R7: res; 1k
R8: res; 1k
R9: res; 10k
R10: res; 11k
R11: res; 11k
R12: res; 1k
R13: res; 1k
R14: res; 1.8k
R15: res; 3.6k
R16: res; 1.8k
R17: res; 100k
R18: res; 100k
R19: res; 1.8k
R20: res; 3.6k
R21: res; 1.8k
R22: res; 100k
R23: res; 100k
R24: res; 10k
R25: res; 1000K
R26: res; 24.9K
R27: res; 24.9K
R28: res; 8.25K
U1: UniversalOpAmp2
U2: UniversalOpAmp2
U3: UniversalOpAmp2
U4: UniversalOpAmp2
U5: UniversalOpAmp2
U6: UniversalOpAmp2
U7: UniversalOpAmp2
U8: UniversalOpAmp2
U9: UniversalOpAmp2
U10: UniversalOpAmp2; Avol=1Meg GBW=1Meg Slew=500k
V1: voltage; 15v
V2: voltage; 15v
V3: voltage; 15v
V4: voltage; 15v
V5: voltage; 15v
V6: voltage; 15v
V7: voltage; 15v
V8: voltage; 15v
V9: voltage; 15v
V10: voltage; 15v
V11: voltage; 15v
V12: voltage; ""; AC 1
V13: voltage; 15v
V14: voltage; 15v
V15: voltage; 15v
V16: voltage; 15v
V17: voltage; 15v
V18: voltage; 15v
V19: voltage; SINE(0 50u 10)
V20: voltage; SINE(0 50u 60)
V21: voltage; SINE(0 50u 120)
V22: voltage; 15v
V23: voltage; ""; AC 1
V26: voltage; 15v
V27: voltage; 15v
V28: voltage; 3V
V29: voltage; 1.5v
V31: voltage; SINE(0 1m 10)
Named nets: 0, in, out, INN, VPLUS, OUT, RG1, RG2, VMINUS, INP, REF
.tran 1
.ac dec 200 0.1 1k
.ac dec 200 0.1 1k
XAD1 INP INN VPLUS VMINUS OUT REF RG1 RG2 AD620A
.inc AD620A.sub
