aaromalonline/cardiokey/hdw_des/notxh_fltr.asc

C1: cap; 1µ
C2: cap; 1µ
C3: cap; 2µ
R1: res; 165
R2: res; 42k
R3: res; 165
U1: ADTL082
V1: voltage; SINE(0 1 60); AC 1
V2: voltage; 15
V3: voltage; 15
Named nets: 0
.ac dec 100 1 1k
