aaromalonline/cardiokey/(commit log)

2026-02-20 sample lead 2 exercise ECGID data added
2026-03-06 current outputs added
2026-03-11 added subj1 chara and corrected 500Hz 250pt to 300Hz sampling 150pt
